crystalliu314/CaT_Stretcher/README.md

# CaT_Stretcher
Design Files for Cell and Tissue Stretcher
