crystalliu314/CaT_Stretcher/Mechanical Design/CaT_BoM.xlsx

Sheet: BoM
Part Number | Description | Quantity | Unit Price | Vendor | Price | Purchase Link
Mechanical components
100 | Slider rail assembly | 1 | 62 | Jian An Machinery | 62
101 | End attachment bracket | 1 | 5 | Custom Machined | 5
102 | Rail attachment bracket | 1 | 1 | 3D Printed | 1
103 | Aluminum extrusion 2020 x 450mm | 2 | 15 | Amazon/AliExpress | 30
104 | PDMS Wells mounting plate | 4 | 1 | 3D Printed | 4
200 | PDMS Wells | 8 | N/A | Custom casting
301 | Well mounting pins - short | 50 | 0.52 | McMaster Carr | 26
302 | Well pins - long | N/A |  | McMaster Carr
303 | M4X12 | 4 | 0.1 | McMaster Carr | 0.4
304 | M5X10 | 28 | 0.2 | McMaster Carr | 5.6
305 | M5X16 | 4 | 0.08 | McMaster Carr | 0.32
Electronics
400 | Electronics control box assembly | 1 | N/A
401 | Arduino Uno | 1 | 5.49 | Amazon/AliExpress | 5.49
402 | PCB | 1 | 15 | JLCPCB + Custom Work | 15
403 | Raspberry Pi 4 | 1 | 75 | CanaKit | 75
404 | Raspberry Pi 7'' Screen | 1 | 54 | Amazon/AliExpress | 54
405 | NEMA23 Stepper | 1 | 10 | Amazon/AliExpress | 10
406 | Emergency Stop | 1 | 2 | AliExpress | 2
407 | Electronics housing base | 1 | 2 | 3D Printed | 2
408 | Electronics housing front cover | 1 | 1 | 3D Printed | 1
409 | Electronics housing back cover | 1 | 1 | 3D Printed | 1
410 | Electronics housing button cover | 1 | 0.5 | 3D Printed | 0.5
411 | 80mm cooling fan | 1 | 2.3 | Amazon/AliExpress | 2.3
306 | M3 nuts | 7 | 0.05 | McMaster Carr | 0.35
307 | M3X14 | 7 | 0.05 | McMaster Carr | 0.35
308 | M3 x 6mm clip standoffs | 7 | 0.06 | Amazon/AliExpress | 0.42
Misc
901 | 12V power supply with USB | 1 | 12.87 | Amazon/AliExpress | 12.87
902 | Keyboard + Mouse | 1 | 40 | Amazon/AliExpress | 40
903 | USB C Pi Power supply | 1 | 10 | Amazon/AliExpress | 10
904 | USB A to B cable | 1 | 0.9 | Amazon/AliExpress | 0.9
905 | USB B female to male right angle adaptor | 1 | 2 | Amazon/AliExpress | 2
906 | MicroHDMI to HDMI cable | 1 | 3 | Amazon/AliExpress | 3
907 | Micro SD card | 1 | 6.5 | Amazon/AliExpress | 6.5
Total |  |  |  |  | 366.6

Sheet: BoM Without Purchase Link
Part Number | Description | Quantity | Unit Price (CAD) | Vendor | Price (CAD)
Mechanical components
100 | Slider rail assembly | 1 | $62.00 | Jian An Machinery | $62.00
101 | End attachment bracket | 1 | $5.00 | Custom Machined | $5.00
102 | Rail attachment bracket | 1 | $1.00 | 3D Printed | $1.00
103 | Aluminum extrusion 2020 x 450mm | 2 | $15.00 | Amazon/AliExpress | $30.00
104 | PDMS Wells mounting plate | 4 | $1.00 | 3D Printed | $4.00
200 | PDMS Wells | 8 | N/A | Custom casting
301 | Well mounting pins - short | 50 | $0.52 | McMaster Carr | $26.00
302 | Well pins - long | N/A |  | McMaster Carr
303 | M4X12 | 4 | $0.10 | McMaster Carr | $0.40
304 | M5X10 | 28 | $0.20 | McMaster Carr | $5.60
305 | M5X16 | 4 | $0.08 | McMaster Carr | $0.32
Electronics
400 | Electronics control box assembly | 1 | N/A
401 | Arduino Uno | 1 | $5.49 | Amazon/AliExpress | $5.49
402 | PCB | 1 | $15.00 | JLCPCB + Custom Work | $15.00
403 | Raspberry Pi 4 | 1 | $75.00 | CanaKit | $75.00
404 | Raspberry Pi 7'' Screen | 1 | $54.00 | Amazon/AliExpress | $54.00
405 | NEMA23 Stepper | 1 | $10.00 | Amazon/AliExpress | $10.00
406 | Emergency Stop | 1 | $2.00 | AliExpress | $2.00
407 | Electronics housing base | 1 | $2.00 | 3D Printed | $2.00
408 | Electronics housing front cover | 1 | $1.00 | 3D Printed | $1.00
409 | Electronics housing back cover | 1 | $1.00 | 3D Printed | $1.00
410 | Electronics housing button cover | 1 | $0.50 | 3D Printed | $0.50
411 | 80mm cooling fan | 1 | $2.30 | Amazon/AliExpress | $2.30
306 | M3 nuts | 7 | $0.05 | McMaster Carr | $0.35
307 | M3X14 | 7 | $0.05 | McMaster Carr | $0.35
308 | M3 x 6mm clip standoffs | 7 | $0.06 | Amazon/AliExpress | $0.42
Miscellaneous
901 | 12V power supply with USB | 1 | $12.87 | Amazon/AliExpress | $12.87
902 | Keyboard + Mouse | 1 | $40.00 | Amazon/AliExpress | $40.00
903 | USB C Pi Power supply | 1 | $10.00 | Amazon/AliExpress | $10.00
904 | USB A to B cable | 1 | $0.90 | Amazon/AliExpress | $0.90
905 | USB B female to male right angle adaptor | 1 | $2.00 | Amazon/AliExpress | $2.00
906 | MicroHDMI to HDMI cable | 1 | $3.00 | Amazon/AliExpress | $3.00
907 | Micro SD card | 1 | $6.50 | Amazon/AliExpress | $6.50
Total |  |  |  |  | $366.60

Sheet: Source Files
Part Number | Description | Quantity | Vendor | Source File
Mechanical components
101 | End attachment bracket | 1 | Custom Machined
102 | Rail attachment bracket | 1 | 3D Printed
104 | PDMS Wells mounting plate | 4 | 3D Printed
200 | PDMS Wells | 8 | Custom casting
Electronics
402 | PCB | 1 | JLCPCB + Custom Work
407 | Electronics housing base | 1 | 3D Printed
408 | Electronics housing front cover | 1 | 3D Printed
409 | Electronics housing back cover | 1 | 3D Printed
