crystalliu314/CaT_Stretcher/Electrical Design/PCB/MMTK.xlsx

Comment | Designator | Footprint | LCSC
100n / 50V | C5,C6,C7,C8,C10,C12,C13,C14,C17,C20,C23,C25,C26,C27,C28 | Capacitor_SMD:C_0603_1608Metric | C14663
22u / 25V | C9,C11 | Capacitor_SMD:C_1206_3216Metric | C12891
330u / 35V | C15,C16 | Capacitor_SMD:CP_Elec_10x10 | C134522
22n / 50V | C21 | Capacitor_SMD:C_0805_2012Metric | C1729
1u / 50V | C22 | Capacitor_SMD:C_1206_3216Metric | C1848
2u2 / 16V | C24 | Capacitor_SMD:C_0603_1608Metric | C23630
10u / 50V | C1,C3,C4,C18,C19 | Capacitor_SMD:C_1206_3216Metric | C13585
Zener 15V | D1 | DO NOT PLACE | DNP
Zener 5V | D2,D8 | DO NOT PLACE | DNP
TVS 28V | D5 | Diode_SMD:D_SMB | C305667
TVS 5V | D6 | Diode_SMD:D_SMB | C440263
LED YELLOW | D10 | LED_SMD:LED_0603_1608Metric | C72038
LED GREEN | D7 | LED_SMD:LED_0603_1608Metric | C72043
LED RED | D9 | LED_SMD:LED_0603_1608Metric | C2286
Fuse | F1 | Fuse:Fuse_2920_7451Metric
4.7uH | L1 | Inductor_SMD:L_Sunlord_MWSA0518_5.4x5.2mm
3.3uH | L2 | Inductor_SMD:L_0805_2012Metric
MMBT3904-TP | Q1,Q3,Q4 | digikey-footprints:SOT-23-3
Q_PMOS_GSD | Q2 | Package_TO_SOT_SMD:SOT-23
20K | R10 | Resistor_SMD:R_0603_1608Metric
100k/1% | R11 | Resistor_SMD:R_0603_1608Metric
1k/1% | R12 | Resistor_SMD:R_0603_1608Metric
1R1/1% | R13 | Resistor_SMD:R_0603_1608Metric
120mR/1W | R15,R16 | Resistor_SMD:R_2512_6332Metric
10K | R1,R4,R7,R17,R18,R21,R22,R25,R31,R32 | Resistor_SMD:R_0603_1608Metric
300K | R2 | Resistor_SMD:R_0603_1608Metric
200R/1% | R14,R26,R28,R30 | Resistor_SMD:R_0603_1608Metric
1K | R27,R29 | Resistor_SMD:R_0603_1608Metric
100K | R3 | Resistor_SMD:R_0603_1608Metric
54.9 | R6 | Resistor_SMD:R_0603_1608Metric
100R | R5,R8,R19,R20,R23,R24 | Resistor_SMD:R_0603_1608Metric
8.2K | R9 | Resistor_SMD:R_0603_1608Metric
B3F-1000 | S2,S3,S4,S5 | digikey-footprints:Switch_Tactile_SMD_6x6mm
SW_SPDT | SW1 | Button_Switch_SMD:SW_SPDT_PCM12
HX711 | U1 | Package_SO:SOIC-16_3.9x9.9mm_P1.27mm
TMC2209 | U2 | Package_DFN_QFN:QFN-28-1EP_5x5mm_P0.5mm_EP3.35x3.35mm_ThermalVias
TPS562200 | U3 | Package_TO_SOT_SMD:SOT-23-6
