crystalliu314/CaT_Stretcher/Mechanical Design/Custom Parts Design Files/3D Printing/407 Electronics housing base.STL

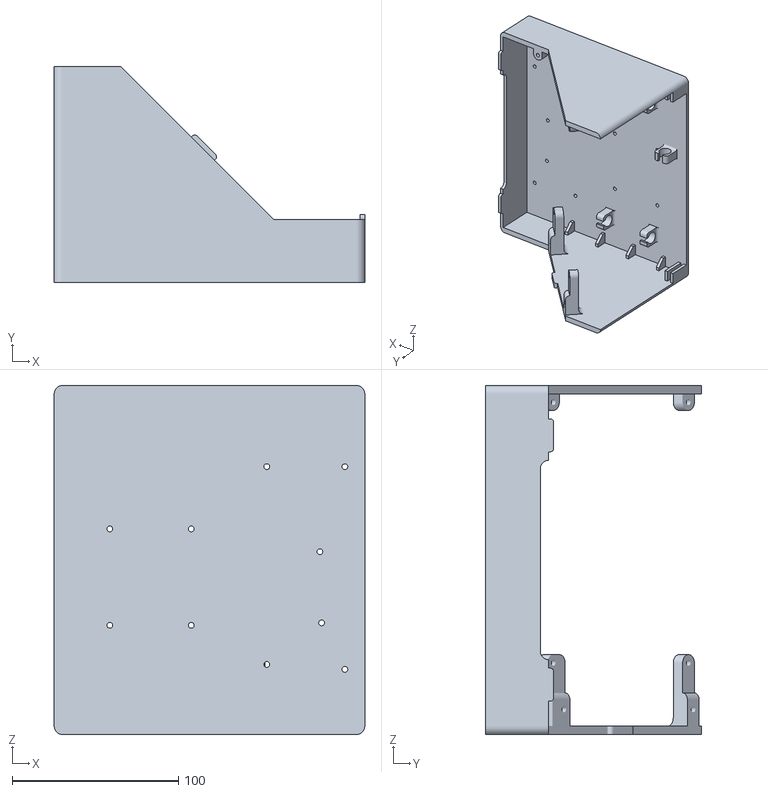
[picture p1: CAD file, 2022-05-22]
Mechanical Design/Custom Parts Design Files/3D Printing/407 Electronics housing base.STL
186.9 x 129.9 x 210.0
