crystalliu314/CaT_Stretcher/Mechanical Design/Custom Parts Design Files/3D Printing/Tissue Slicing and Clamps/blade holder V2.stl

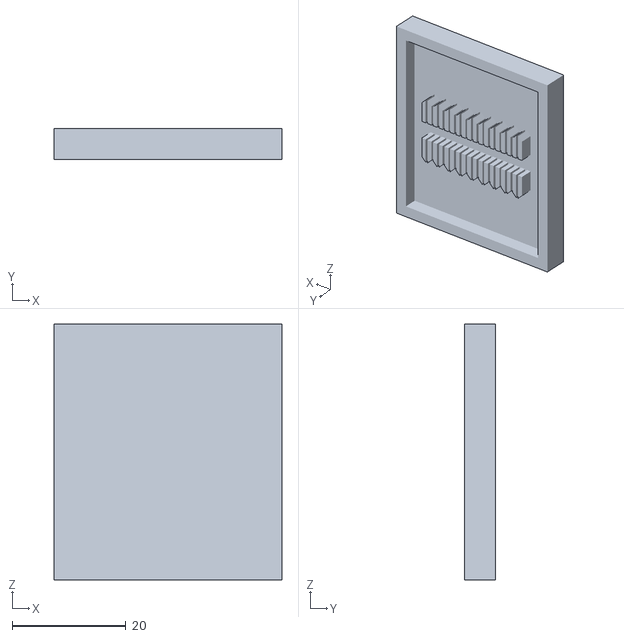
[picture p2: CAD file, 2022-05-31]
Mechanical Design/Custom Parts Design Files/3D Printing/Tissue Slicing and Clamps/blade holder V2.stl
40.0 x 5.50 x 45.0
