crystalliu314/CaT_Stretcher/Mechanical Design/Custom Parts Design Files/Casting/20X20 mold/PDMS Chamber Mold - V9 Steven.stl

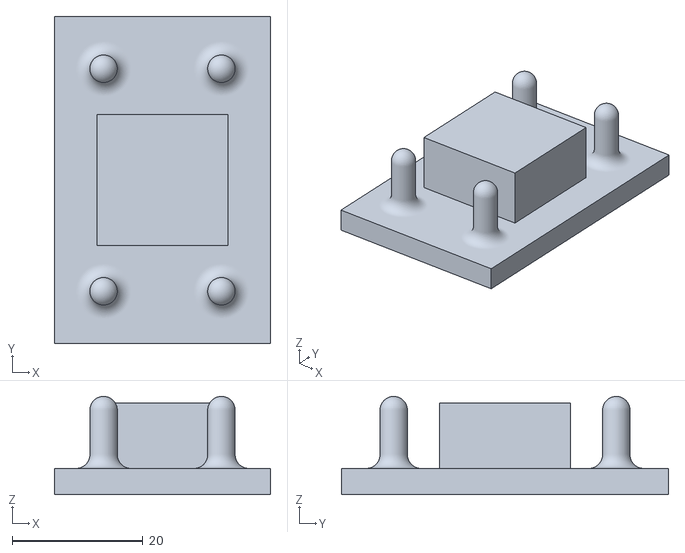
[picture p3: CAD file, 2022-05-24]
Mechanical Design/Custom Parts Design Files/Casting/20X20 mold/PDMS Chamber Mold - V9 Steven.stl
33.0 x 50.0 x 15.0
