crystalliu314/CaT_Stretcher/Mechanical Design/Custom Parts Design Files/Casting/60x20 mold/Long PDMS Chamber-Mold V7.stp

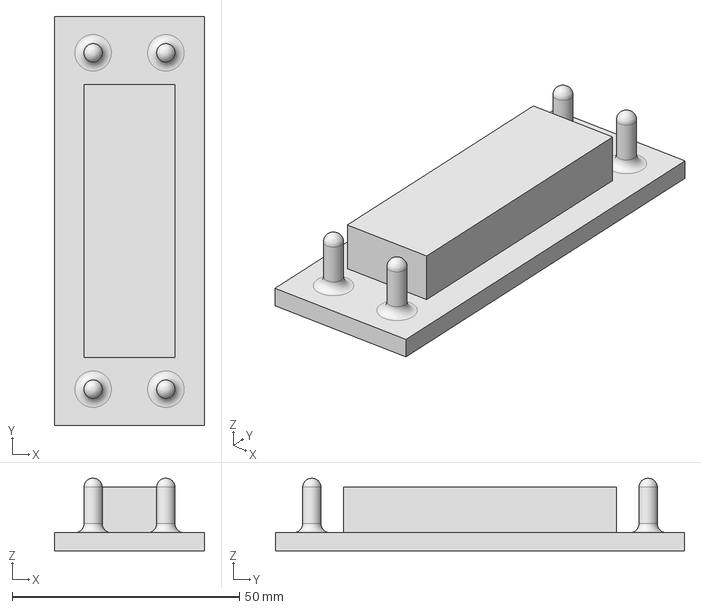
[picture p4: CAD file, 2022-05-22]
Mechanical Design/Custom Parts Design Files/Casting/60x20 mold/Long PDMS Chamber-Mold V7.stp
33.0 x 90.0 x 16.0 mm
