crystalliu314/CaT_Stretcher/Mechanical Design/Custom Parts Design Files/Machining/101 End attachment bracket.STEP

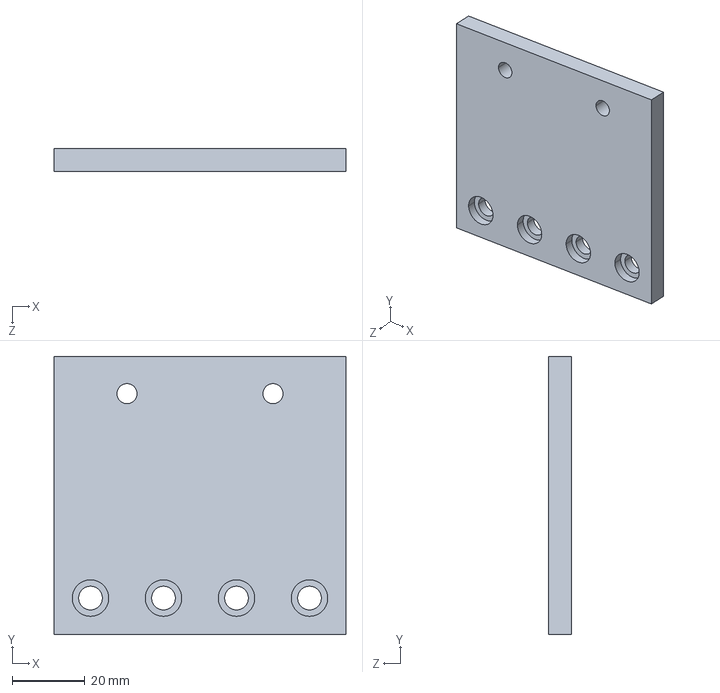
[picture p5: CAD file, 2022-05-22]
Mechanical Design/Custom Parts Design Files/Machining/101 End attachment bracket.STEP
80.0 x 76.2 x 6.35 mm
