crystalliu314/CaT_Stretcher/Mechanical Design/Custom Parts Design Files/3D Printing/409 Electronics housing back cover.STL

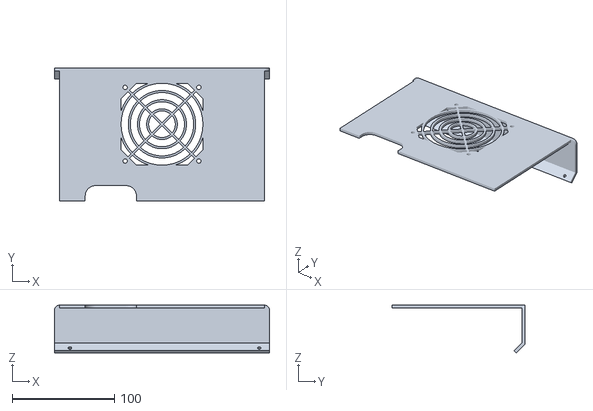
[picture p6: CAD file, 2022-05-22]
Mechanical Design/Custom Parts Design Files/3D Printing/409 Electronics housing back cover.STL
210.0 x 129.9 x 46.7
