crystalliu314/CaT_Stretcher/Mechanical Design/Custom Parts Design Files/3D Printing/Tissue Slicing and Clamps/3mm thick - inner box.stl

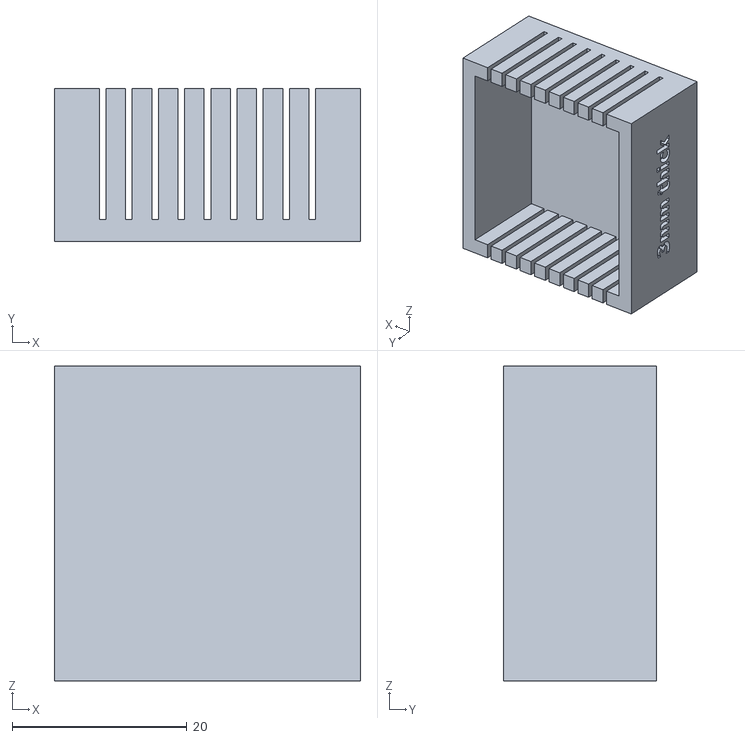
[picture p7: CAD file, 2022-05-24]
Mechanical Design/Custom Parts Design Files/3D Printing/Tissue Slicing and Clamps/3mm thick - inner box.stl
35.0 x 17.5 x 36.0
