crystalliu314/CaT_Stretcher/Mechanical Design/Custom Parts Design Files/Casting/20X20 mold/PDMS Chamber left-right - V9.stl

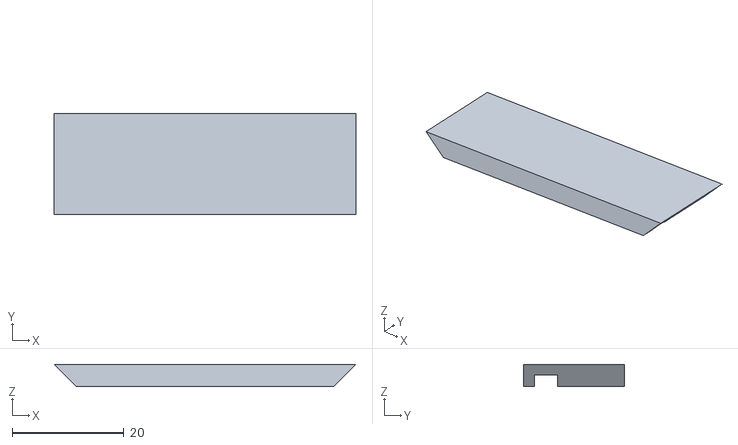
[picture p8: CAD file, 2022-05-22]
Mechanical Design/Custom Parts Design Files/Casting/20X20 mold/PDMS Chamber left-right - V9.stl
54.0 x 18.0 x 4.00
