crystalliu314/CaT_Stretcher/Mechanical Design/Custom Parts Design Files/Casting/60x20 mold/long PDMS Chamber top-bottom - V7.stp

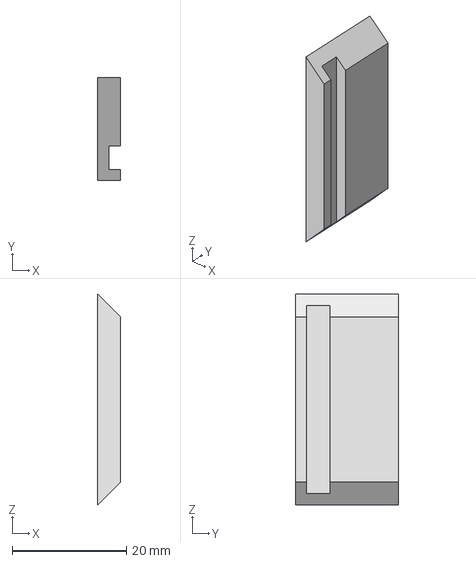
[picture p9: CAD file, 2022-05-22]
Mechanical Design/Custom Parts Design Files/Casting/60x20 mold/long PDMS Chamber top-bottom - V7.stp
4.00 x 18.0 x 37.0 mm
