crystalliu314/CaT_Stretcher/Mechanical Design/Custom Parts Design Files/3D Printing/102 Rail attachment bracket.STL

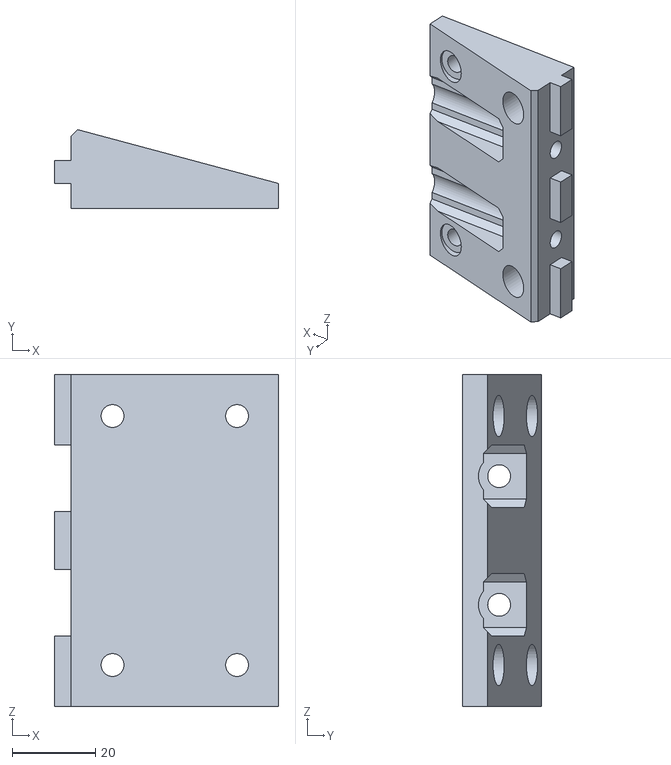
[picture p10: CAD file, 2022-05-22]
Mechanical Design/Custom Parts Design Files/3D Printing/102 Rail attachment bracket.STL
54.0 x 19.0 x 80.0
