crystalliu314/CaT_Stretcher/Mechanical Design/Custom Parts Design Files/3D Printing/Tissue Slicing and Clamps/V4 tissue bottom clamp.stl

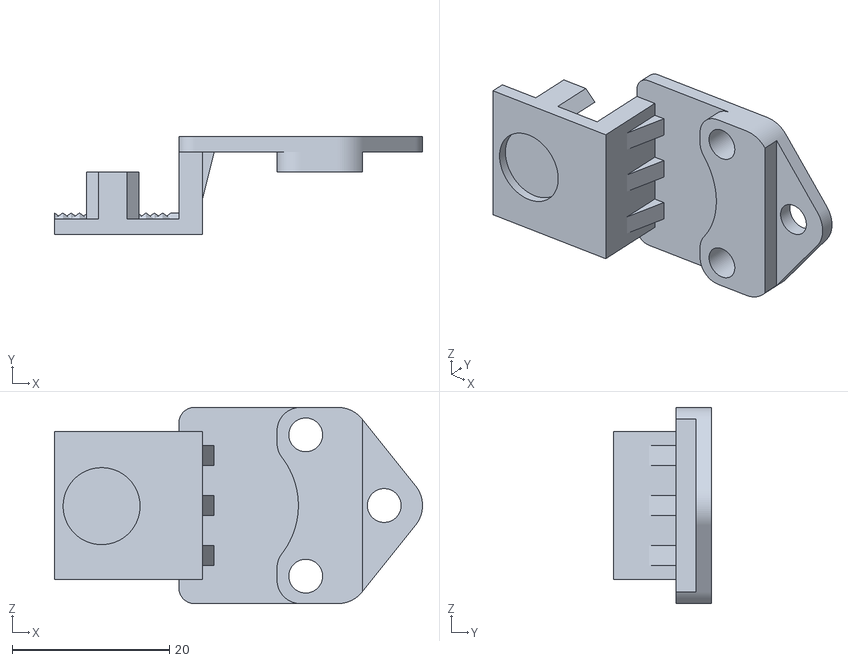
[picture p11: CAD file, 2022-05-24]
Mechanical Design/Custom Parts Design Files/3D Printing/Tissue Slicing and Clamps/V4 tissue bottom clamp.stl
46.9 x 12.5 x 25.0
