crystalliu314/CaT_Stretcher/Mechanical Design/Custom Parts Design Files/Casting/60x20 mold/long PDMS Chamber left-right - V7.stp

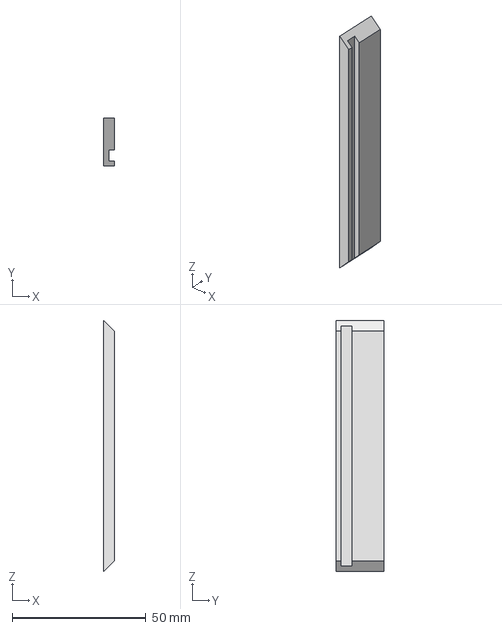
[picture p12: CAD file, 2022-05-22]
Mechanical Design/Custom Parts Design Files/Casting/60x20 mold/long PDMS Chamber left-right - V7.stp
4.00 x 18.0 x 94.0 mm
