crystalliu314/CaT_Stretcher/Mechanical Design/Custom Parts Design Files/3D Printing/104 PDMS Wells mounting plate.STL

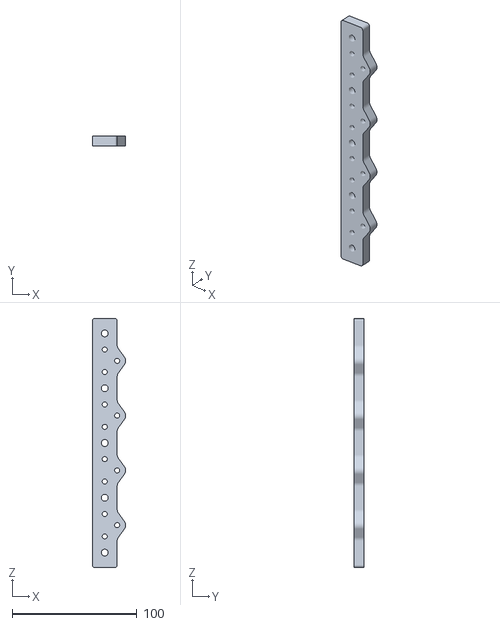
[picture p13: CAD file, 2022-05-22]
Mechanical Design/Custom Parts Design Files/3D Printing/104 PDMS Wells mounting plate.STL
26.8 x 8.00 x 200.0
