crystalliu314/CaT_Stretcher/Mechanical Design/Custom Parts Design Files/3D Printing/Tissue Slicing and Clamps/V4 tissue top clamp.stl

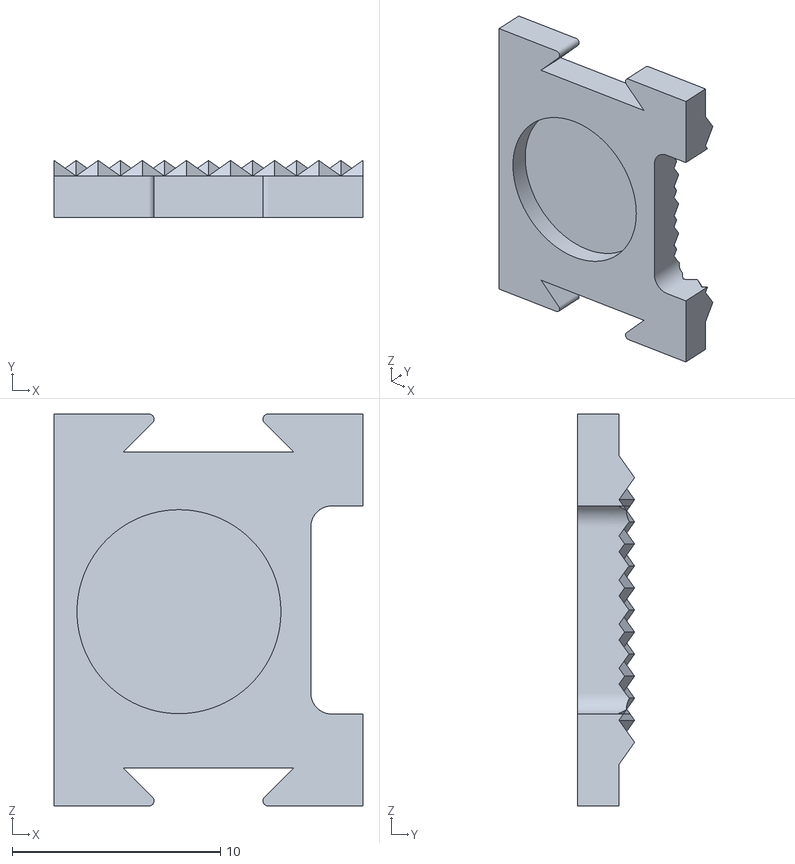
[picture p14: CAD file, 2022-05-24]
Mechanical Design/Custom Parts Design Files/3D Printing/Tissue Slicing and Clamps/V4 tissue top clamp.stl
14.8 x 2.75 x 18.8
