crystalliu314/CaT_Stretcher/Mechanical Design/Custom Parts Design Files/3D Printing/408 Electronics housing front cover.STL

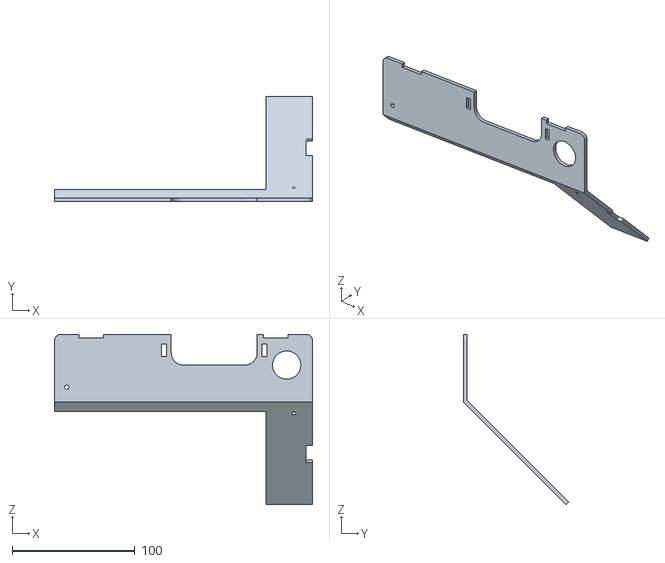
[picture p15: CAD file, 2022-05-22]
Mechanical Design/Custom Parts Design Files/3D Printing/408 Electronics housing front cover.STL
210.0 x 85.7 x 138.6
