crystalliu314/CaT_Stretcher/Mechanical Design/Custom Parts Design Files/3D Printing/Tissue Slicing and Clamps/3mm thick - outer box.stl

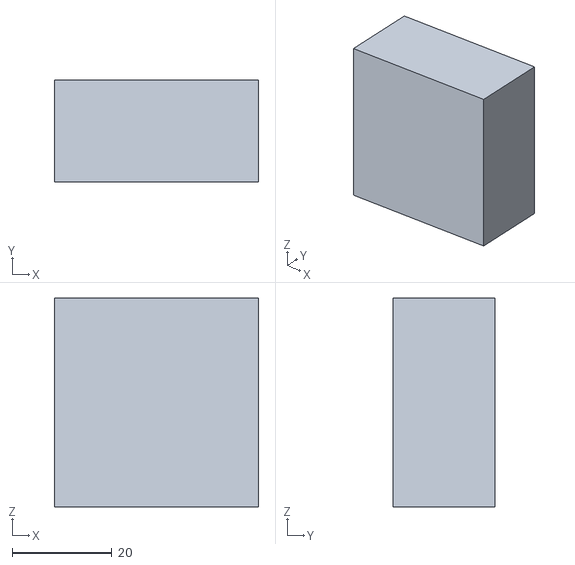
[picture p16: CAD file, 2022-05-24]
Mechanical Design/Custom Parts Design Files/3D Printing/Tissue Slicing and Clamps/3mm thick - outer box.stl
41.0 x 20.5 x 42.0
