crystalliu314/CaT_Stretcher/Mechanical Design/Custom Parts Design Files/3D Printing/410 Electronics housing button cover.STL

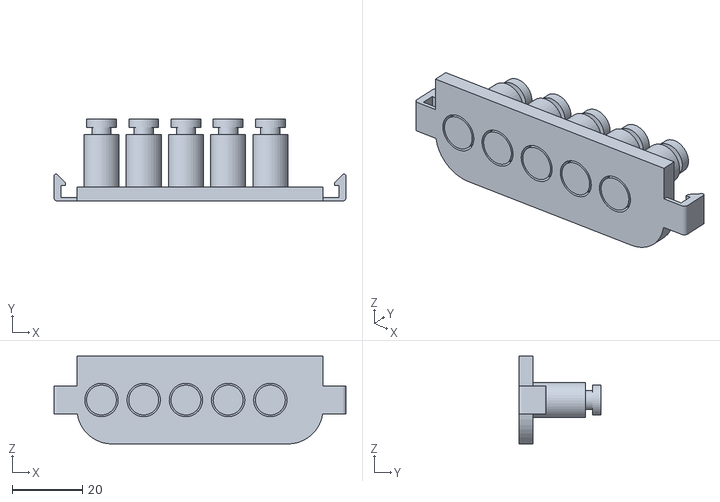
[picture p17: CAD file, 2022-05-22]
Mechanical Design/Custom Parts Design Files/3D Printing/410 Electronics housing button cover.STL
83.0 x 23.4 x 25.0
