crystalliu314/CaT_Stretcher/(list of files, cad)

Other CAD files:
Mechanical Design/Custom Parts Design Files/Casting/Stereolithography sketches/suppFig_hydrogelPillarSketch v1.dwg
Mechanical Design/Custom Parts Design Files/Casting/Stereolithography sketches/suppFigOrganChipSketch v0.dwg
Mechanical Design/Custom Parts Design Files/Casting/20X20 mold/PDMS Chamber top-bottom - V9.stl
Mechanical Design/Custom Parts Design Files/Casting/Stereolithography sketches/suppFigMonolayerSketch v0.dwg
Mechanical Design/Custom Parts Design Files/Casting/60x20 mold/Long PDMS Chamber-Mold V7.ipt
Mechanical Design/Custom Parts Design Files/Casting/60x20 mold/Long PDMS Chamber-Mold V7.stl
Mechanical Design/Custom Parts Design Files/Casting/60x20 mold/long PDMS Chamber left-right - V7.ipt
Mechanical Design/Custom Parts Design Files/Casting/60x20 mold/long PDMS Chamber left-right - V7.stl
Mechanical Design/Custom Parts Design Files/Casting/60x20 mold/long PDMS Chamber top-bottom - v7.ipt
