crystalliu314/CaT_Stretcher/CaT Stretcher User Manual.pdf

# CaT Stretcher User Manual

Updated: 2023/09/10 by Steven Wang

## GitHub Repository:

https://github.com/crystalliu314/CaT_Stretcher

## Prepare the Actuation Unit:

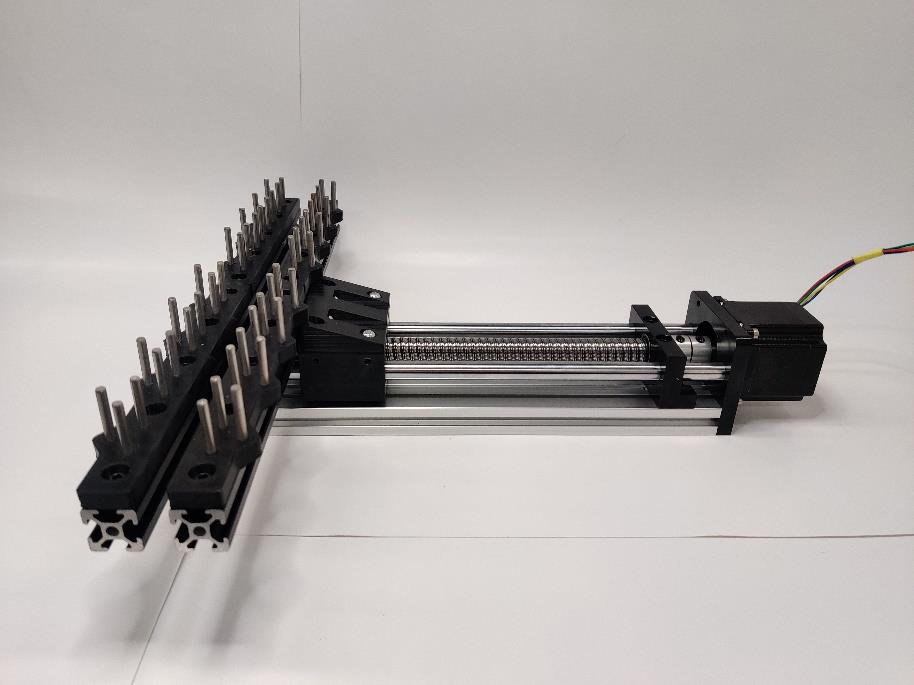
[picture p18: figure]

1. Print the following parts:
From GitHub Repo Path: CaT_Stretcher/Mechanical Design/Custom Parts Design Files /3D Printing/

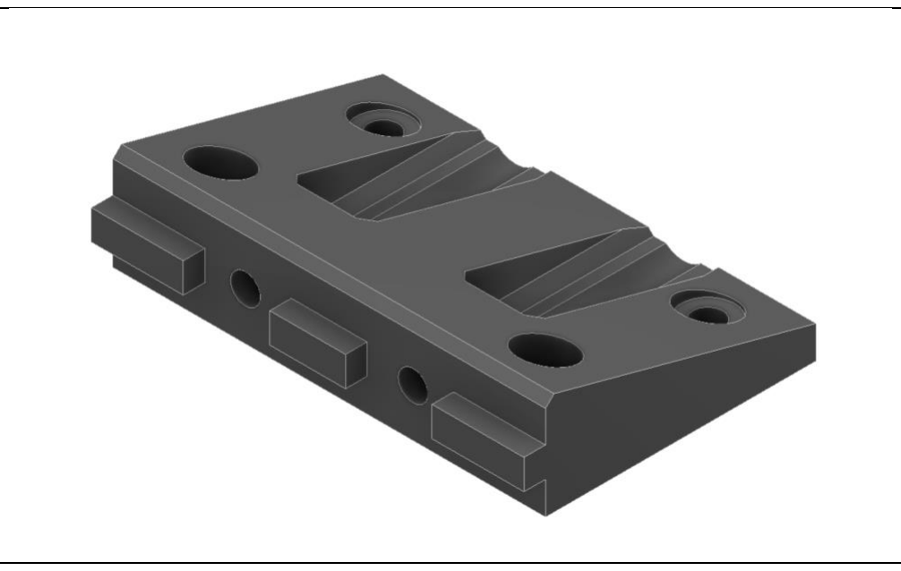
[picture p19: figure]

Rail Attachment Bracket | X1

PDMS Wells Mounting Plate X4

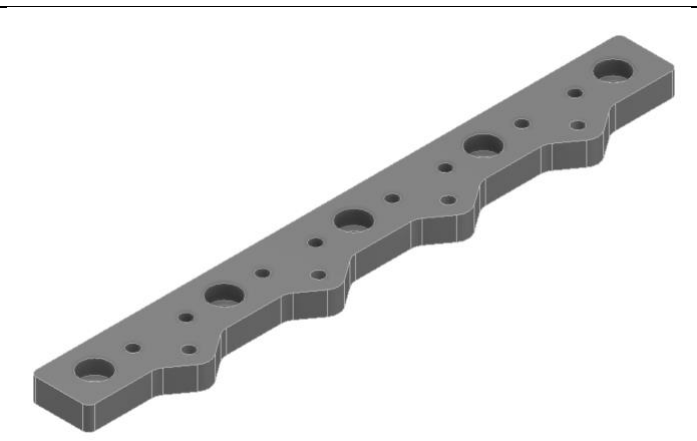
[picture p20: figure]

2. Secure the Rail Attachment Bracket to the Rail System using 4X M5x10 screws.

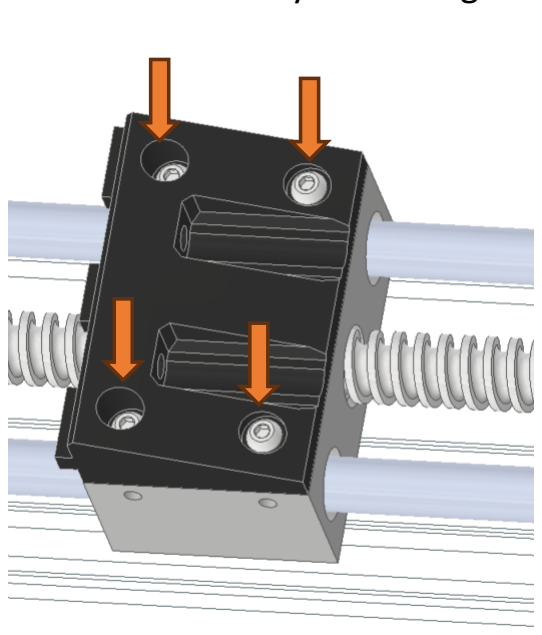
[picture p21: figure]

3. Attach an aluminum extrusion to the Rail Attachment Bracket using 2X M5x10 screws and M5 T-nuts (T-nuts slide into the grooves of the extrusion)

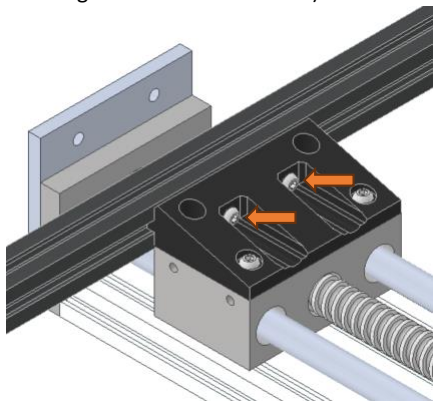
[picture p22: figure]

4. Use another pair of M5x10 screws and M5 T-nuts to fix a second aluminum extrusion to the End Attachment Bracket.

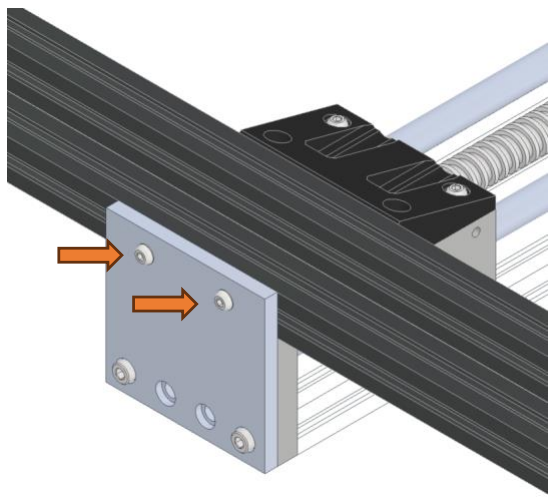
[picture p23: figure]

5. Hammer 4X30mm dowel pins into the PDMS Wells Mounting Plates (X4). Note the orientation of the mounting plates.

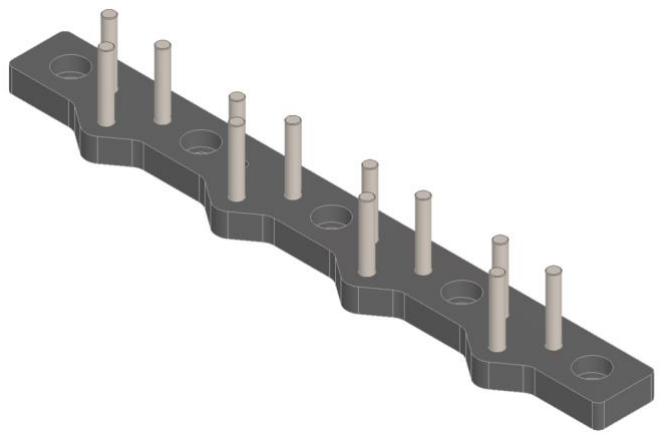
[picture p24: figure]

6. Install a pair of PDMS Wells Mounting Plates onto each aluminum extrusion using M5X10 screws and M5 T-nuts. Make sure the orientation of each mounting plate matches picture below.

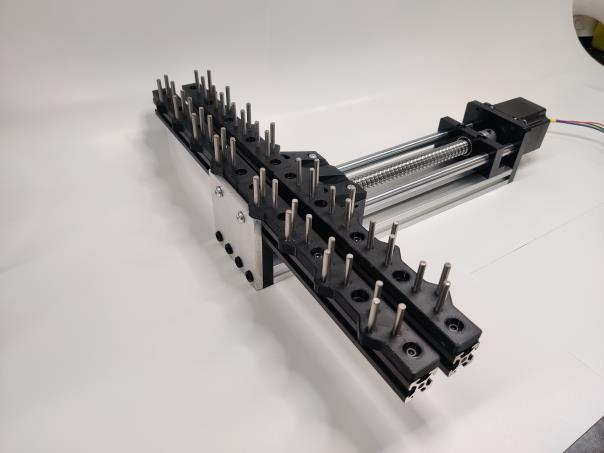
[picture p25: figure]

## Making all Wired Connections & Launching Application

### CaT V1

Setup 1: Using 2 power supplies (recommended)
1. Locate the 12V barrel power supply. Use a flat head screwdriver to make sure the small red dial is set to 12V.

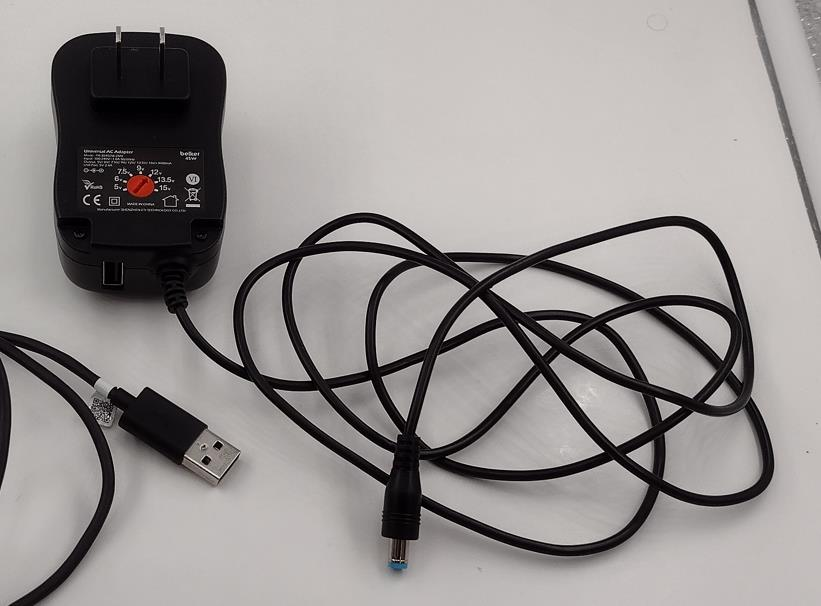
[picture p26: figure]

Alternatively, the 12V barrel power supply for CaT V2 can also be used.

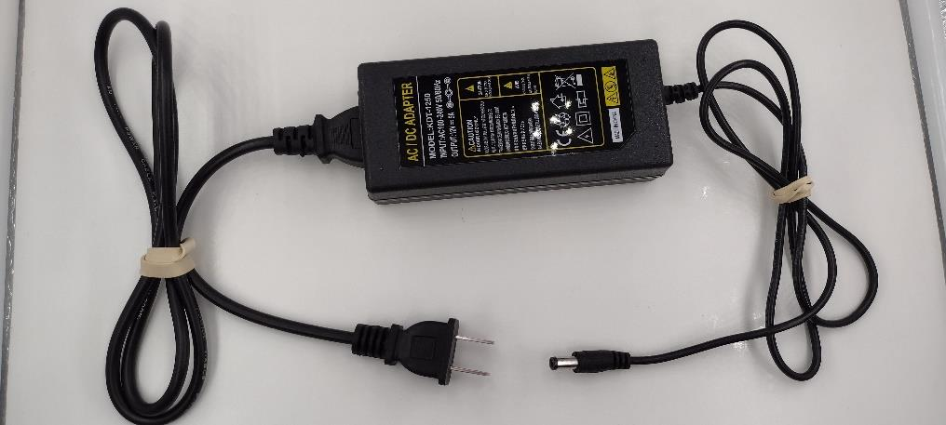
[picture p27: figure]
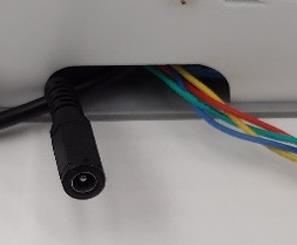
[picture p28: figure]

2. Plug the barrel connector into the female port on the control unit.

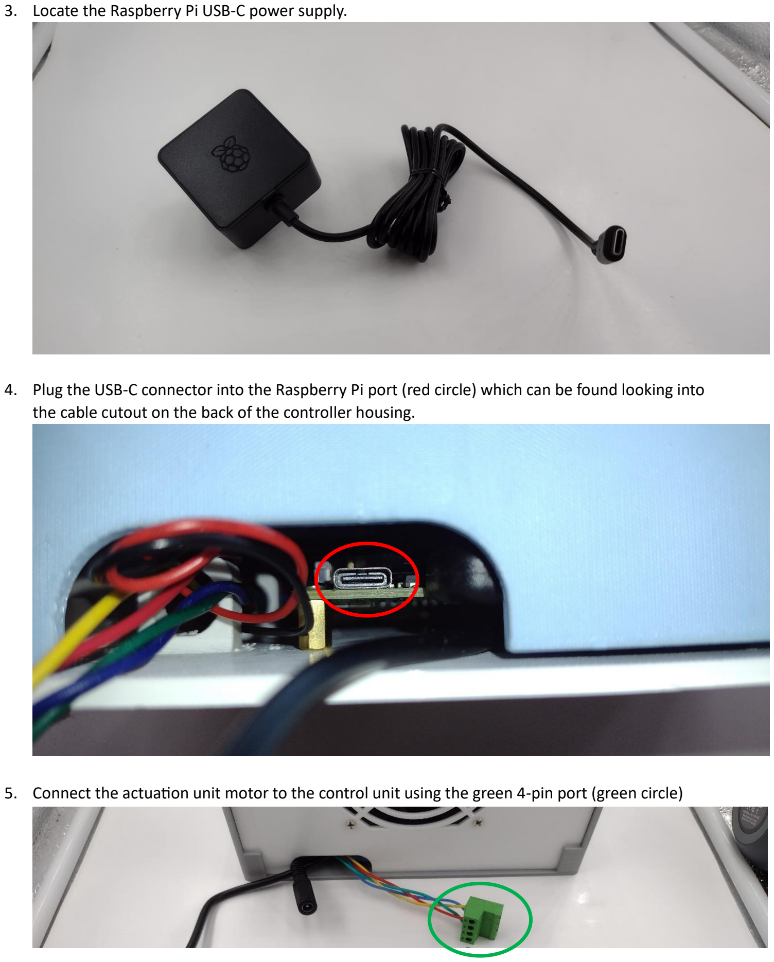
[picture p29: page 7]

3. Locate the Raspberry Pi USB-C power supply.
4. Plug the USB-C connector into the Raspberry Pi port (red circle) which can be found looking into the cable cutout on the back of the controller housing.
5. Connect the actuation unit motor to the control unit using the green 4-pin port (green circle)

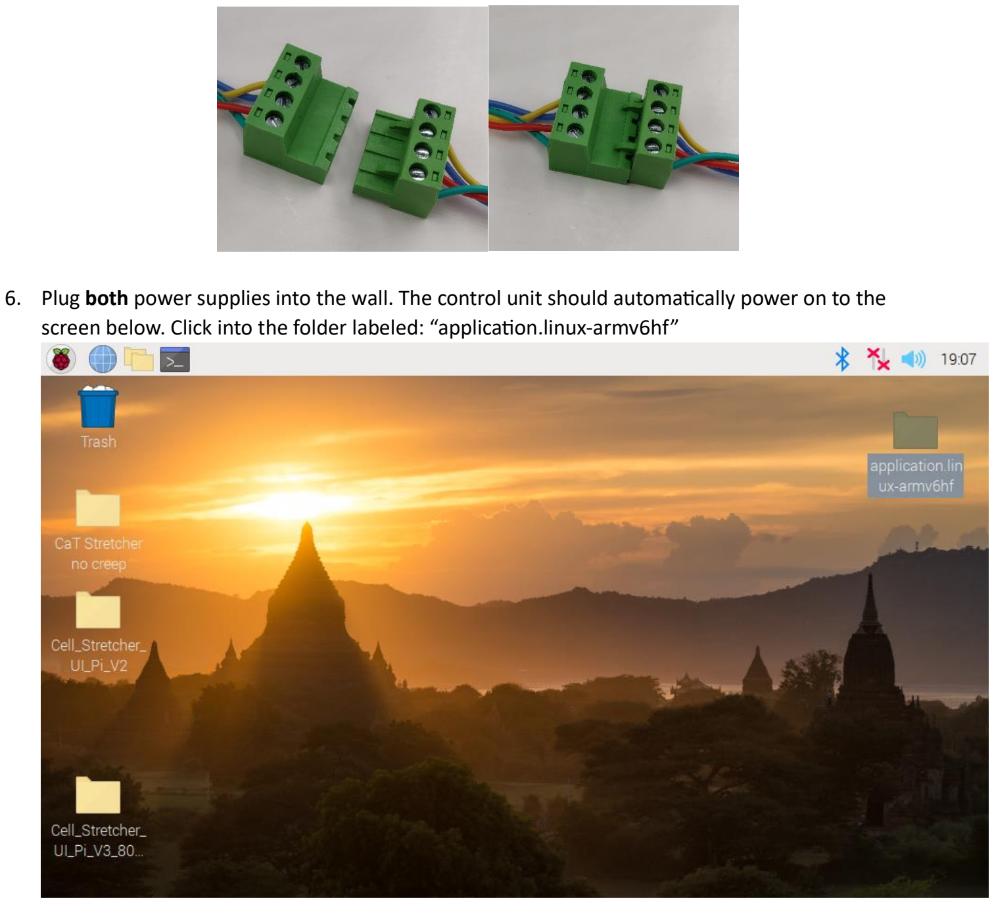
[picture p30: page 8]

6. Plug both power supplies into the wall. The control unit should automatically power on to the screen below. Click into the folder labeled: “application.linux-armv6hf”

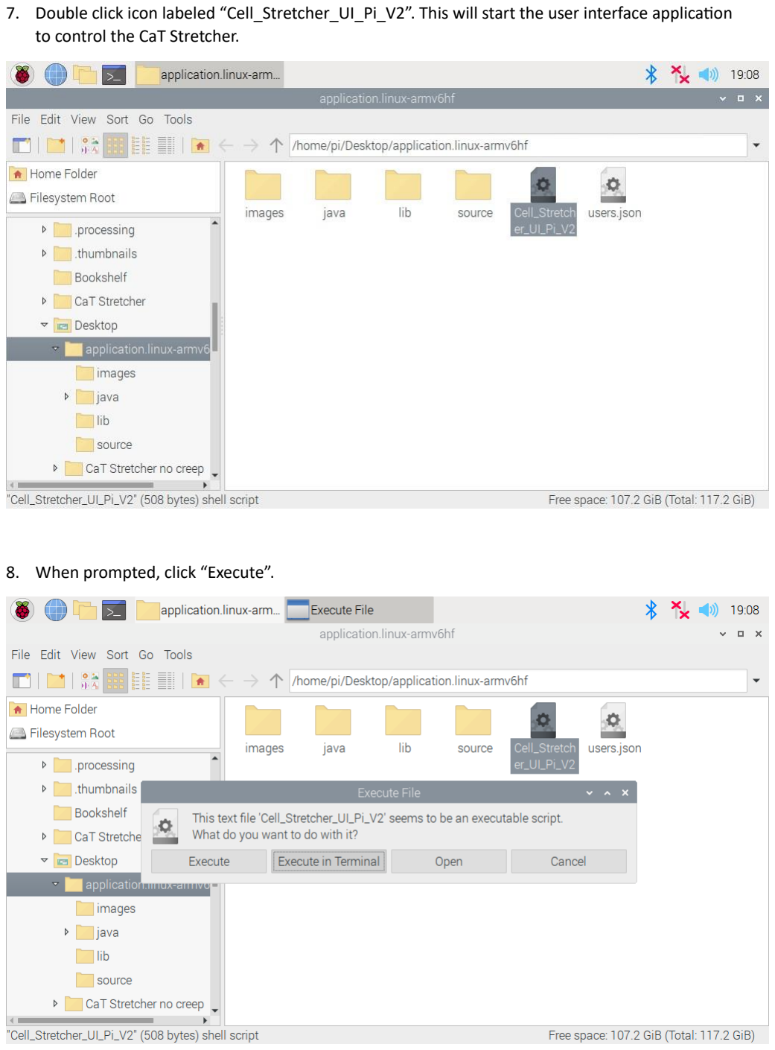
[picture p31: page 9]

7. Double click icon labeled “Cell_Stretcher_UI_Pi_V2”. This will start the user interface application to control the CaT Stretcher.
8. When prompted, click “Execute”.

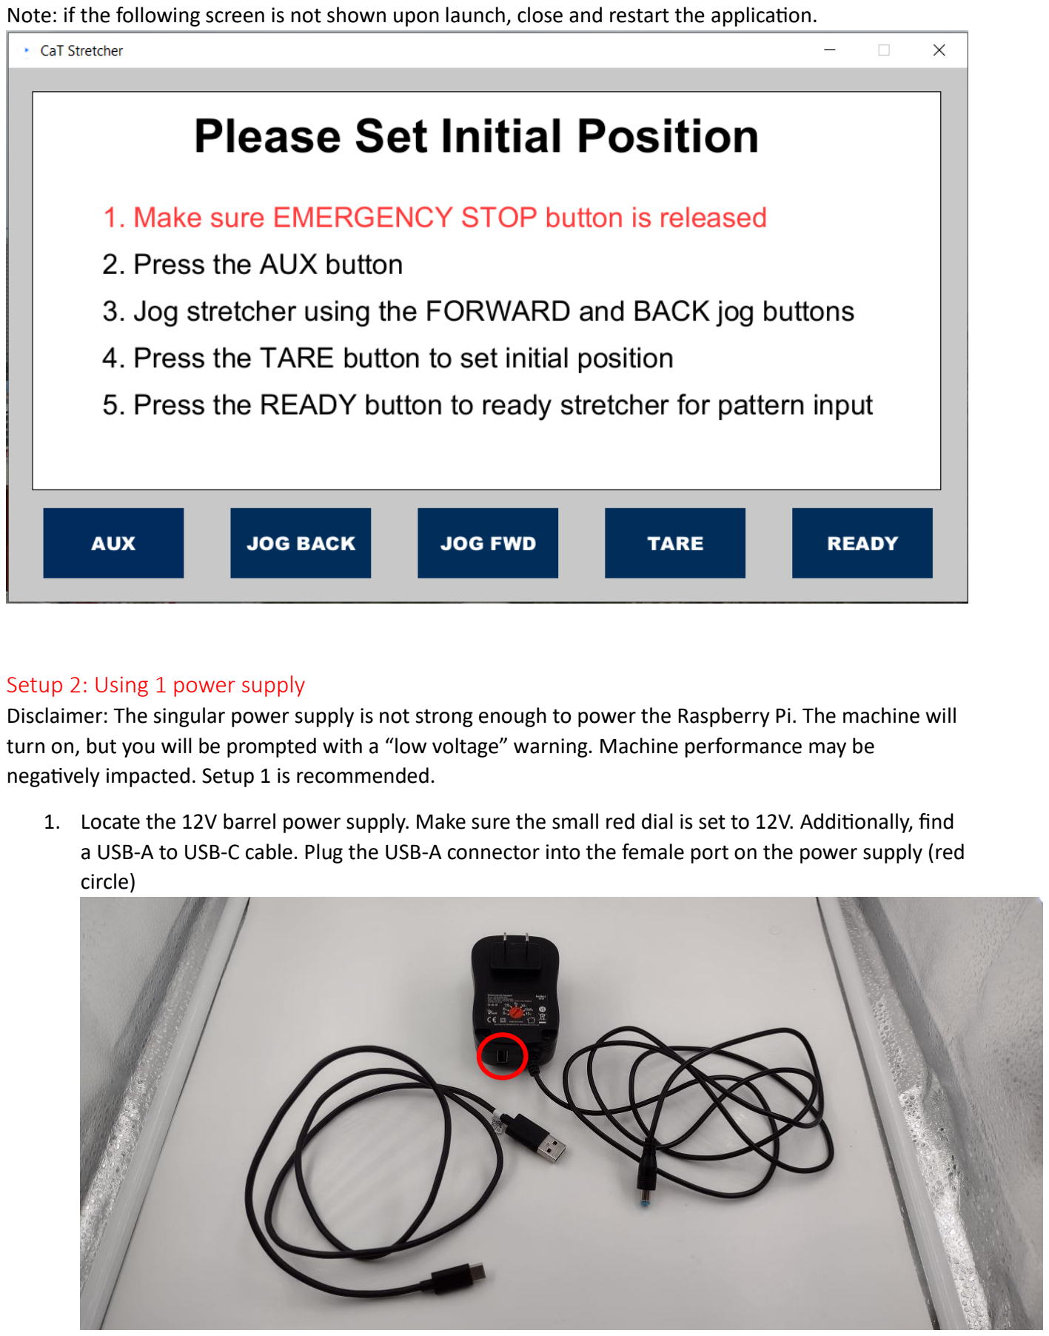
[picture p32: page 10]

Note: if the following screen is not shown upon launch, close and restart the application.

Setup 2: Using 1 power supply
Disclaimer: The singular power supply is not strong enough to power the Raspberry Pi. The machine will turn on, but you will be prompted with a “low voltage” warning. Machine performance may be negatively impacted. Setup 1 is recommended.
1. Locate the 12V barrel power supply. Make sure the small red dial is set to 12V. Additionally, find a USB-A to USB-C cable. Plug the USB-A connector into the female port on the power supply (red circle)

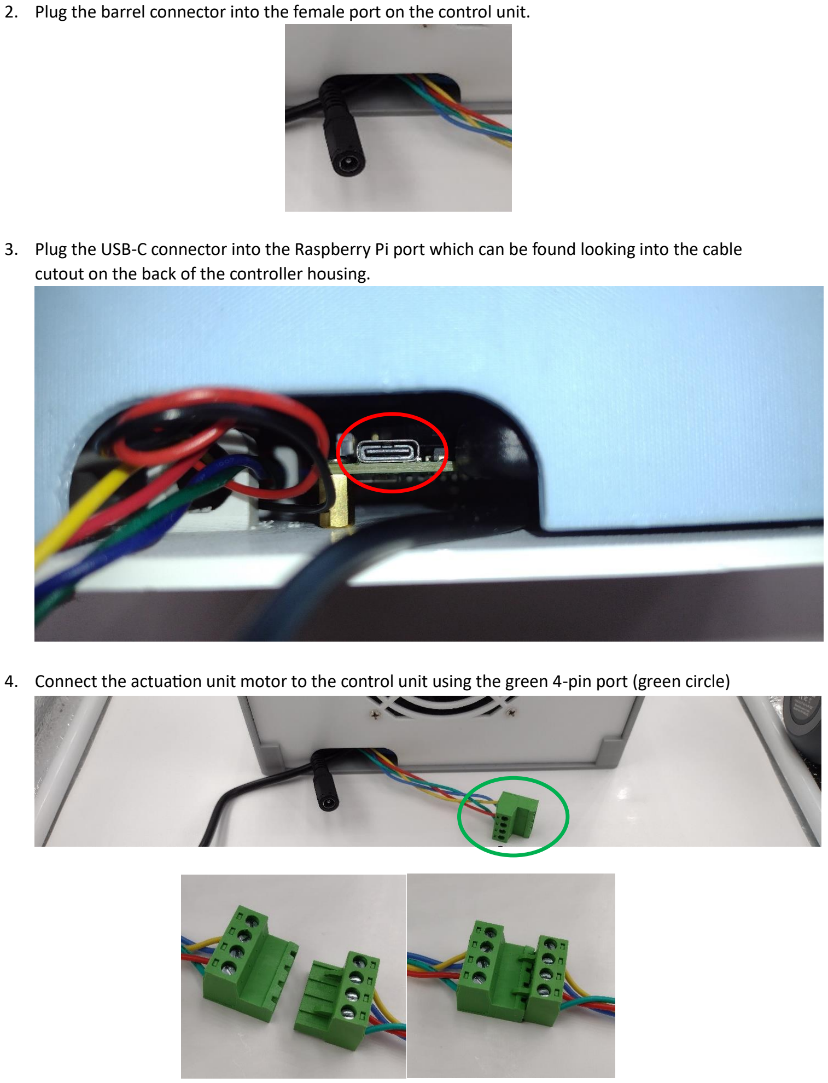
[picture p33: page 11]

2. Plug the barrel connector into the female port on the control unit.
3. Plug the USB-C connector into the Raspberry Pi port which can be found looking into the cable cutout on the back of the controller housing.
4. Connect the actuation unit motor to the control unit using the green 4-pin port (green circle)

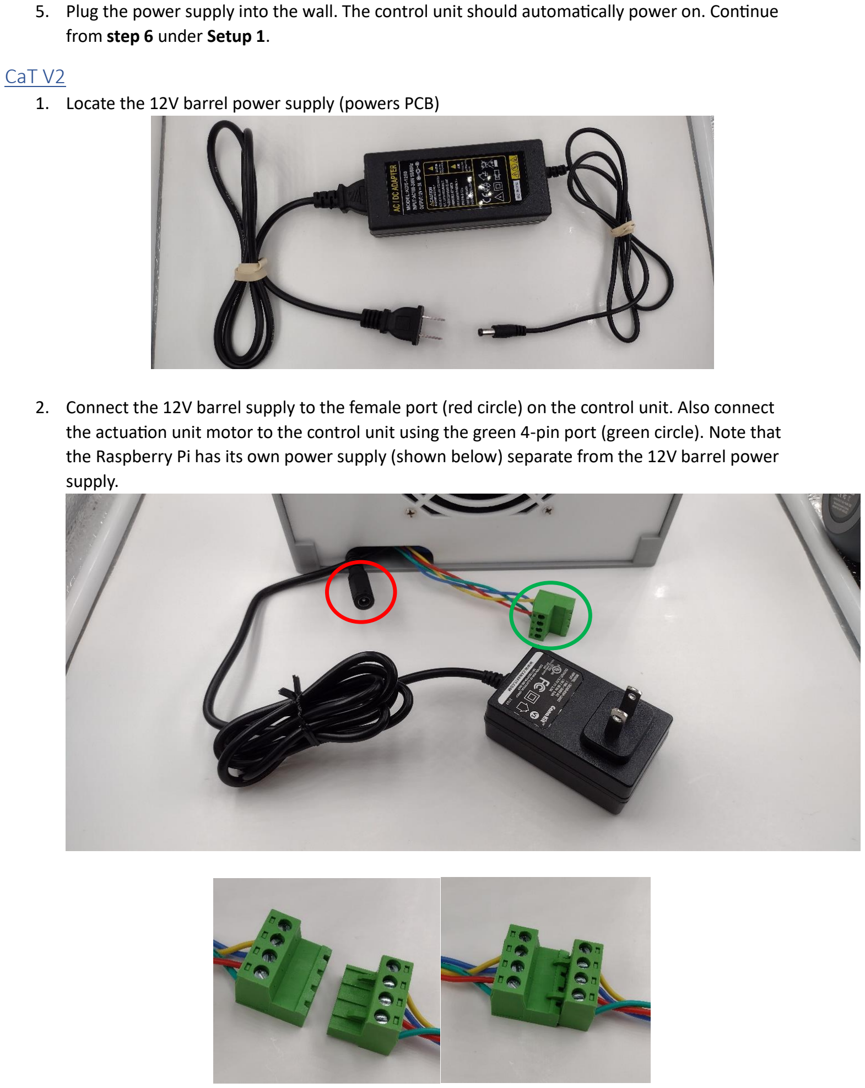
[picture p34: page 12]

5. Plug the power supply into the wall. The control unit should automatically power on. Continue from step 6 under Setup 1.

### CaT V2

1. Locate the 12V barrel power supply (powers PCB)
2. Connect the 12V barrel supply to the female port (red circle) on the control unit. Also connect the actuation unit motor to the control unit using the green 4-pin port (green circle). Note that the Raspberry Pi has its own power supply (shown below) separate from the 12V barrel power supply.

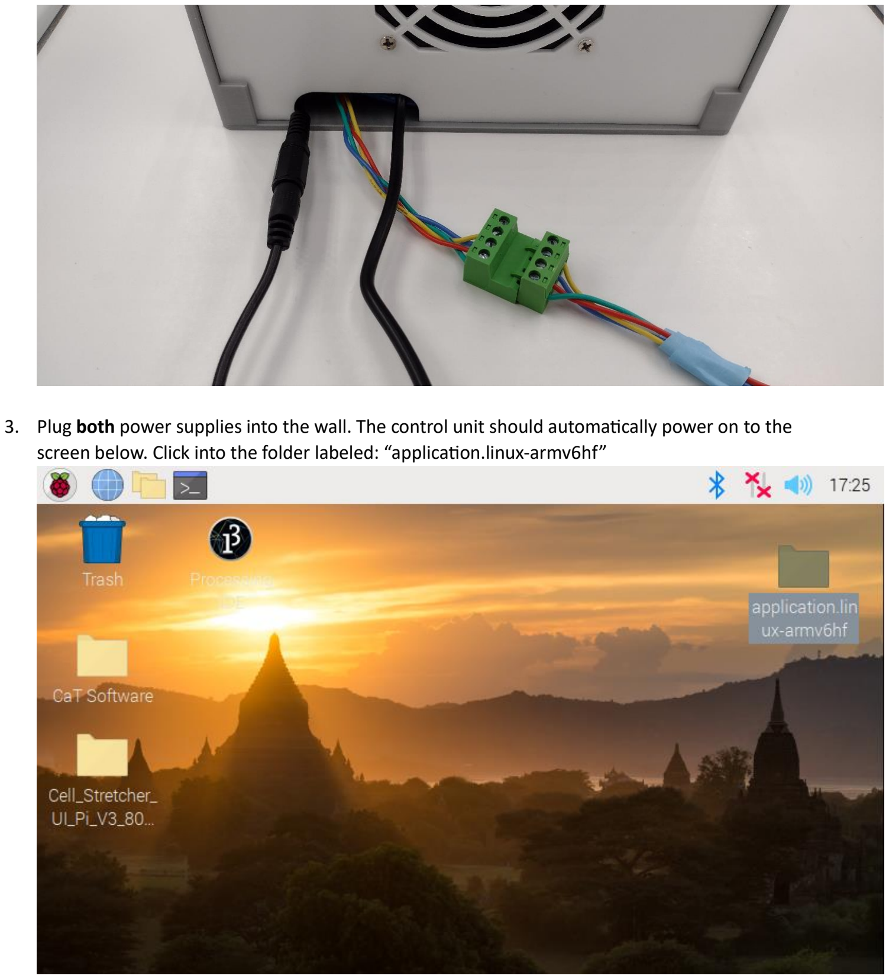
[picture p35: page 13]

3. Plug both power supplies into the wall. The control unit should automatically power on to the screen below. Click into the folder labeled: “application.linux-armv6hf”

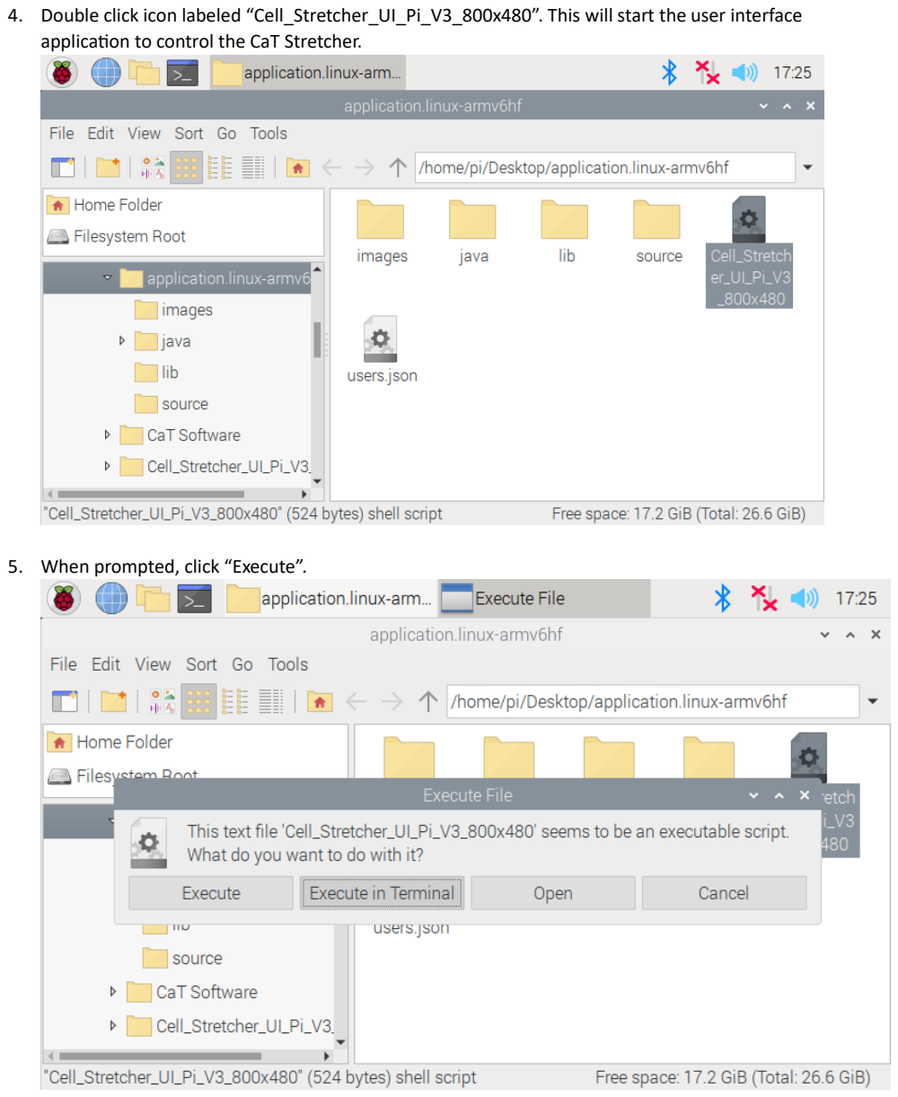
[picture p36: page 14]

4. Double click icon labeled “Cell_Stretcher_UI_Pi_V3_800x480”. This will start the user interface application to control the CaT Stretcher.
5. When prompted, click “Execute”.

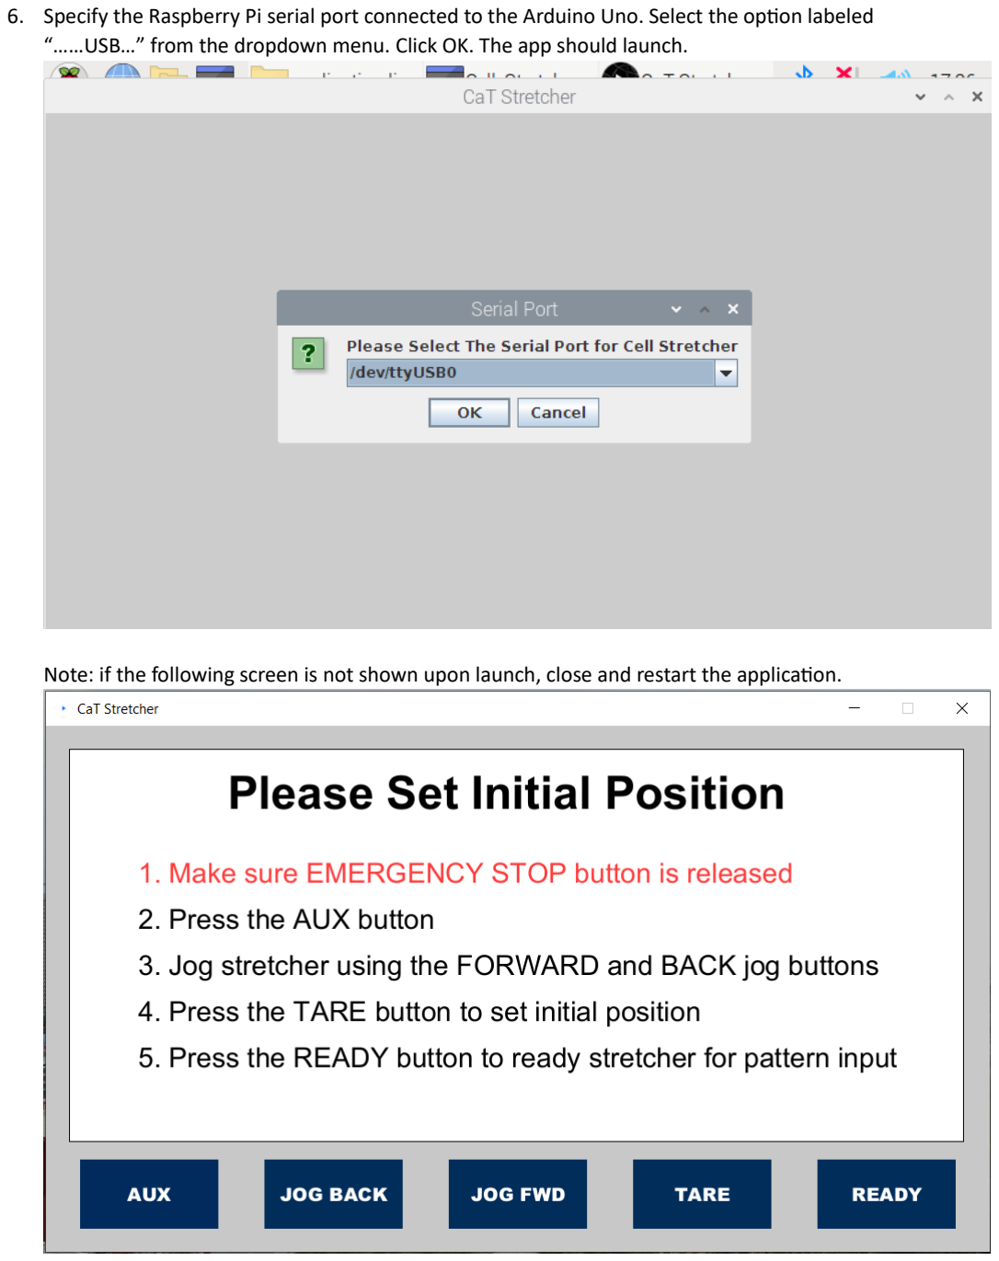
[picture p37: page 15]

6. Specify the Raspberry Pi serial port connected to the Arduino Uno. Select the option labeled “……USB…” from the dropdown menu. Click OK. The app should launch.

Note: if the following screen is not shown upon launch, close and restart the application.
