crystalliu314/CaT_Stretcher/(commit log)

2022-05-22 PCB design
    MMTK PCB design - adapted for CaT stretcher
    [Buttons.sch, ESTOP.sch, HX771.sch, LCD.sch, LEDs.sch, MMTK.csv, MMTK.kicad_pcb, MMTK.sch]
2022-05-22 Mechanical Design and Manufacturing Files
    [101 End attachment bracket.STEP, 102 Rail attachment bracket.STL, 104 PDMS Wells mounting plate.STL, 407 Electronics housing base.STL, 408 Electronics housing front cover.STL, 409 Electronics housing back cover.STL, 410 Electronics housing button cover.STL, CaT_BoM.xlsx]
2022-05-24 tissue slicing and clamp design files
    [3mm thick - inner box.stl, 3mm thick - outer box.stl, V4 tissue bottom clamp.stl, V4 tissue top clamp.stl]
2022-05-24 20X20 Mold FIles
    [PDMS Chamber Mold - V9 Steven.stl, PDMS Chamber left-right - V9.stl, PDMS Chamber top-bottom - V9.stl, PDMS Chamber-Mold-V8-Left Right Wall.ipt, PDMS Chamber-Mold-V8-Left Right Wall.stp, PDMS Chamber-Mold-V8-Top Bottom Wall.ipt, PDMS Chamber-Mold-V8-Top Bottom Wall.stl, PDMS Chamber-Mold-V8-Top Bottom Wall.stp]
2022-05-24 Stereolithography Sketches
    [suppFigMonolayerSketch v0.dwg, suppFigOrganChipSketch v0.dwg, suppFig_hydrogelPillarSketch v1.dwg]
2022-05-31 CaT Controller Housing Assembly Manual
2022-05-31 Tissue Cutting Blade Holder
    [blade holder V2.stl]
2023-05-16 Updated CaT Assembly Manual
